cybaer/ClockOmat/HW/ClockOmat.kicad_pcb

## KiCad design HW/ClockOmat.kicad_pcb (2021-09-26)

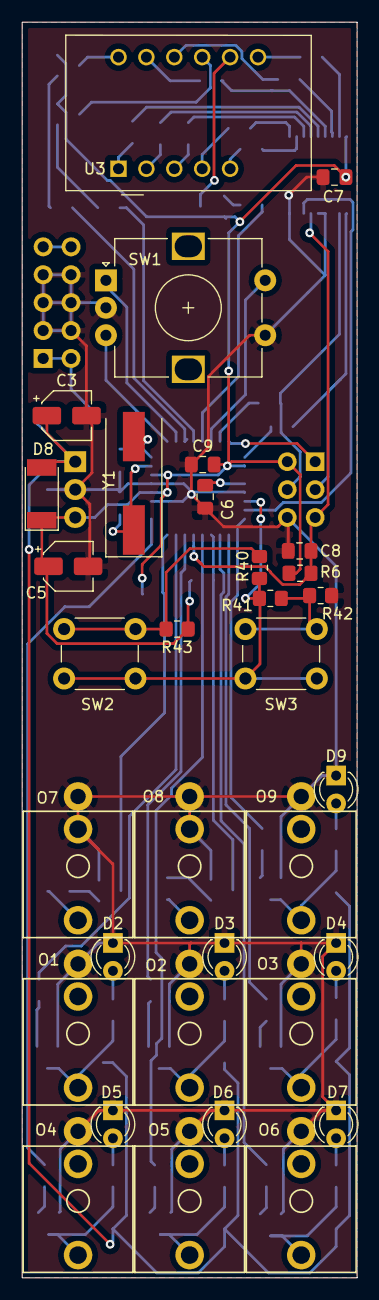
[picture p1: board ClockOmat.kicad_pcb from above]

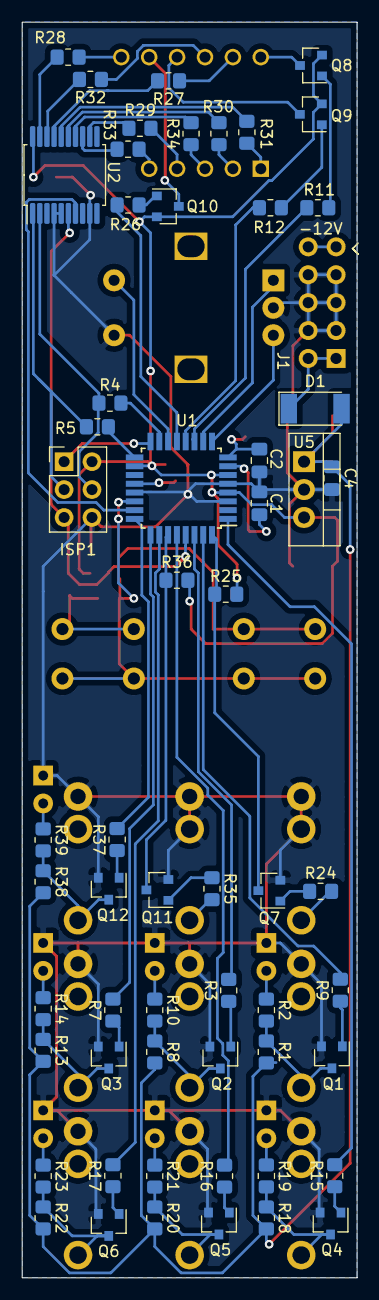
[picture p2: board ClockOmat.kicad_pcb from below]

Board: 2 copper layers, 30.5 x 114.3 mm, 92 parts (59 on the bottom side), 79 nets.

Parts:
C1, C2: 22p; C_0805_2012Metric_Pad1.18x1.45mm_HandSolder
C3, C5: 22µ; CP_Elec_4x5.4
C4, C6, C7, C8, C9: 100nF; C_0805_2012Metric_Pad1.18x1.45mm_HandSolder
D1, D8: DIODE; D_MELF
D2, D3, D4, D5, D6, D7, D9: LED; LED_D3.0mm
ISP1: AVR-ISP-6; PinHeader_2x03_P2.54mm_Vertical
J1: EurorackPower; EurorackPower10
O1, O2, O3, O4, O5, O6, O7, O8, O9: Thonkiconn
Q1, Q2, Q3, Q4, Q5, Q6, Q7, Q11, Q12: BC817; SOT-23
Q8, Q9, Q10: BC807; SOT-23
R1, R3, R6, R7, R8, R9, R13, R15, R16, R17, R18, R20, R22, R25, R36, R37, R38: 10K; R_0805_2012Metric_Pad1.20x1.40mm_HandSolder
R2, R10, R14, R19, R21, R23, R39: 4K7; R_0805_2012Metric_Pad1.20x1.40mm_HandSolder
R4, R5: 100; R_0805_2012Metric_Pad1.20x1.40mm_HandSolder
R11, R12, R26: 1K; R_0805_2012Metric_Pad1.20x1.40mm_HandSolder
R24, R35, R40, R41, R42: 100K; R_0805_2012Metric_Pad1.20x1.40mm_HandSolder
R27, R28, R29, R30, R31, R32, R33, R34: 330; R_0805_2012Metric_Pad1.20x1.40mm_HandSolder
R43: 47K; R_0805_2012Metric_Pad1.20x1.40mm_HandSolder
SW1: Rotary_Encoder_Switch; RotaryEncoder_Alps_EC12E-Switch_Vertical_H20mm
SW2, SW3: SW_Push; SW_PUSH_6mm_H8mm
U1: ATmega328P-AU; TQFP-32_7x7mm_P0.8mm
U2: MCP23S08-xSS-20; SSOP-20_5.3x7.2mm_P0.65mm
U3: CA56-12EWA; BA36-12LSR
U5: L7805; TO-220-3_Vertical
Y1: Crystal; Crystal_SMD_HC49-SD

Connections:
+5V: C5.1, C7.2, C9.2, D8.1, ISP1.2, Q8.2, Q9.2, Q10.2, R6.1, R25.2, R36.2, R43.1, U1.4, U1.6, U1.18, U2.20, U5.3
+12V: C3.1, C4.1, D1.2, D8.2, R1.2, R8.2, R13.2, R18.2, R20.2, R22.2, R38.2, U5.1
But: R40.2, R41.1, SW2.2, SW3.1, U1.22
CS: U1.23, U2.7
Clock: Q7.3, R25.1, U1.32
D1: Q8.3, U3.12
D2: Q9.3, U3.9
D3: Q10.3, U3.8
Dig1: R11.2, U1.11
Dig2: R12.2, U1.12
Dig3: R26.2, U1.13
ENC_A: SW1.A, U1.10
ENC_B: SW1.B, U1.9
ENC_S: SW1.S1, U1.14
GNDD: C1.1, C2.1, C3.2, C4.2, C5.2, C6.2, C7.1, C8.2, C9.1, D2.1, D3.1, D4.1, D5.1, D6.1, D7.1, D9.1, ISP1.6, J1.2, O1.3, O2.3, O3.3, O4.3, O5.3, O6.3, O7.2, O7.3, O8.2, O8.3, O9.3, Q1.2, Q2.2, Q3.2, Q4.2, Q5.2, Q6.2, Q7.2, Q11.2, Q12.2, R42.2, SW1.C, SW1.S2, U1.3, U1.5, U1.21, U2.4, U2.5, U2.9, U5.2
MISO: ISP1.1, U1.16
MOSI: ISP1.4, R4.1, U2.2
unnamed: C1.2, U1.7, Y1.1
unnamed: C2.2, U1.8, Y1.2
unnamed: C6.1, U1.20
unnamed: D1.1, J1.1
unnamed: D2.2, R2.1
unnamed: D3.2, R10.1
unnamed: D4.2, R14.1
unnamed: D5.2, R19.1
unnamed: D6.2, R21.1
unnamed: D7.2, R23.1
unnamed: D9.2, R39.1
unnamed: O1.1, Q1.3, R1.1, R2.2
unnamed: O2.1, Q2.3, R8.1, R10.2
unnamed: O3.1, Q3.3, R13.1, R14.2
unnamed: O4.1, Q4.3, R18.1, R19.2
unnamed: O5.1, Q5.3, R20.1, R21.2
unnamed: O6.1, Q6.3, R22.1, R23.2
unnamed: O7.1, R24.2
unnamed: O8.1, R35.2
unnamed: O9.1, Q12.3, R38.1, R39.2
unnamed: Q1.1, R9.1
unnamed: Q2.1, R3.1
unnamed: Q3.1, R7.1
unnamed: Q4.1, R15.1
unnamed: Q5.1, R16.1
unnamed: Q6.1, R17.1
unnamed: Q7.1, R24.1
unnamed: Q8.1, R11.1
unnamed: Q9.1, R12.1
unnamed: Q10.1, R26.1
unnamed: Q11.1, R35.1
unnamed: Q12.1, R37.1
unnamed: R4.2, U1.15
unnamed: R5.2, U1.17
unnamed: R27.1, U3.11
unnamed: R28.1, U3.7
unnamed: R29.1, U3.4
unnamed: R30.1, U3.2
unnamed: R31.1, U3.1
unnamed: R32.1, U3.10
unnamed: R33.1, U3.5
unnamed: R34.1, U3.3
unnamed: R40.1, R43.2, SW2.1
unnamed: R41.2, R42.1, SW3.2
RST: C8.1, ISP1.5, R6.2, U1.29, U2.6
Res: Q11.3, R36.1, U1.27
SCK: ISP1.3, R5.1, U2.1
a: R27.2, U2.17
b: R28.2, U2.19
c: R29.2, U2.12
d: R30.2, U2.15
e: R31.2, U2.16
f: R32.2, U2.18
g: R33.2, U2.13
out: R37.2, U1.24
out1: R9.2, U1.31
out2: R3.2, U1.30
out3: R7.2, U1.25
out4: R15.2, U1.1
out5: R16.2, U1.28
out6: R17.2, U1.26
p: R34.2, U2.14
