cybaer/ClockOmat/(commit log)

2021-05-17 first release (ordered)
    [ClockOmat.kicad_pcb, ClockOmat.sch]
2021-08-31 first try, display driver
2021-09-26 some error corrections
    [ClockOmat.kicad_pcb, ClockOmat.sch]
